MetafuseTech/CHOPPER/README.md

CHOPPER is a 3D-printable pelletizer made to sit on your desk and run on drills or steppers. It can cut filaments and any polymer strand up to 2mm in diameter into ~3mm pellets.

Check the assembly instructions on YouTube : https://www.youtube.com/watch?v=YQxp2BWjgcM

CHOPPER

Metafuse CHOPPER - Open-Source STL Files
Copyright (C) 2025 Metafuse

These STL files are released under the GNU General Public License v3.0 (GPLv3).
You are free to use, share, modify, and remix them, as long as derivative works
are also released under GPLv3.

Trademarks:
The following names and marks are NOT covered by the GPLv3 license and may not
be used for derivative or commercial releases:

- Metafuse
- Subsolid
- Materium
- Metafuse CHOPPER

Derivatives must not imply official affiliation with Metafuse.  
See the LICENSE file for full legal terms.
