MetafuseTech/CHOPPER/3D Print Files/Main Body Front.stl

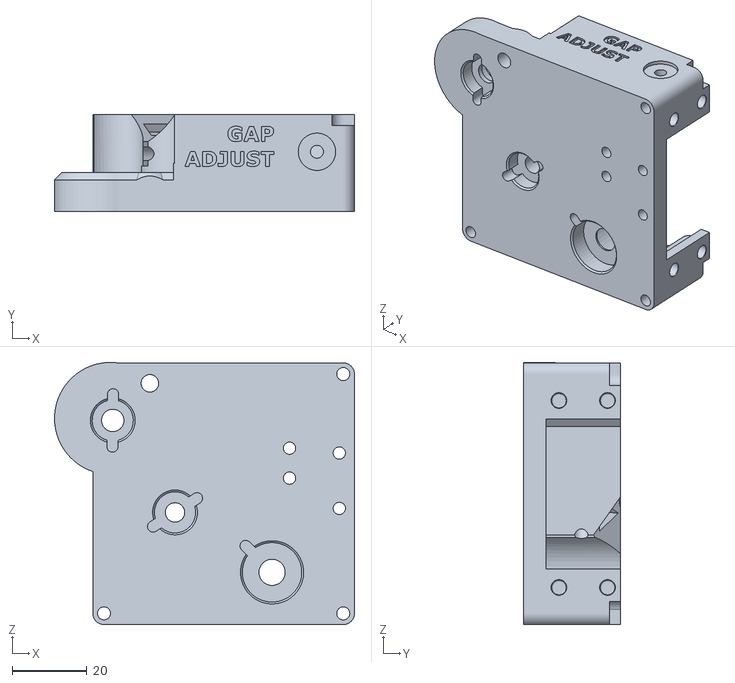
[picture p2: CAD file, 2026-10-27]
3D Print Files/Main Body Front.stl
80.2 x 26.0 x 70.1
