MetafuseTech/CHOPPER/3D Print Files/Main Body Rear.stl

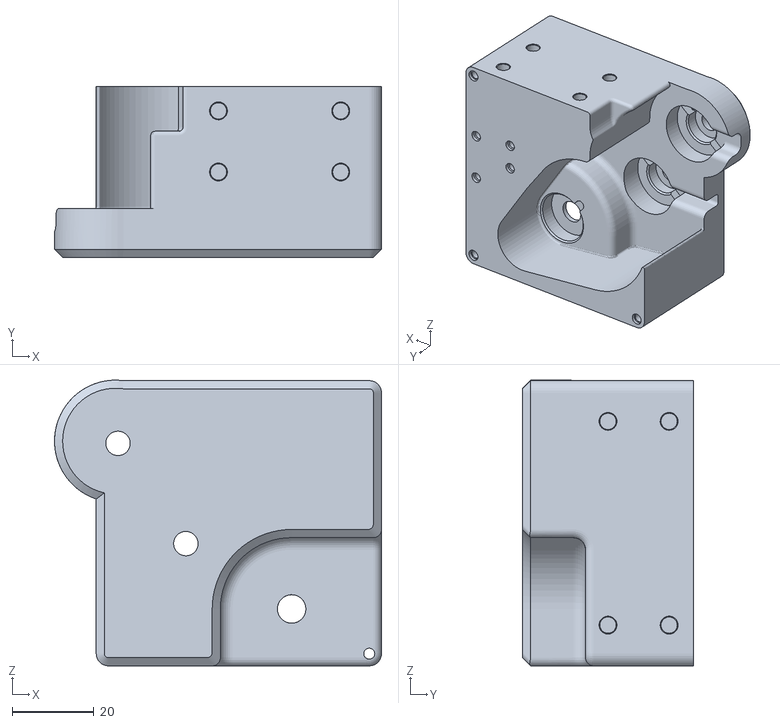
[picture p3: CAD file, 2026-10-27]
3D Print Files/Main Body Rear.stl
80.2 x 42.0 x 70.1
