MetafuseTech/CHOPPER/3D Print Files/Knife Dock.stl

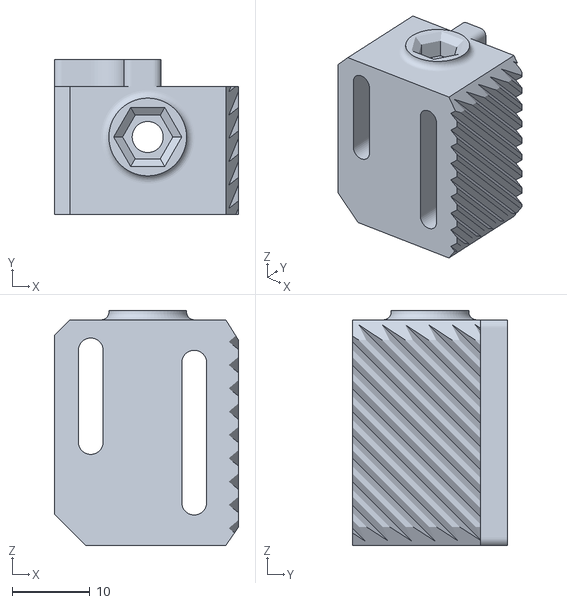
[picture p4: CAD file, 2026-10-27]
3D Print Files/Knife Dock.stl
23.7 x 20.0 x 30.2
