MetafuseTech/CHOPPER/Laser Cut Files/Clear Cover.dxf

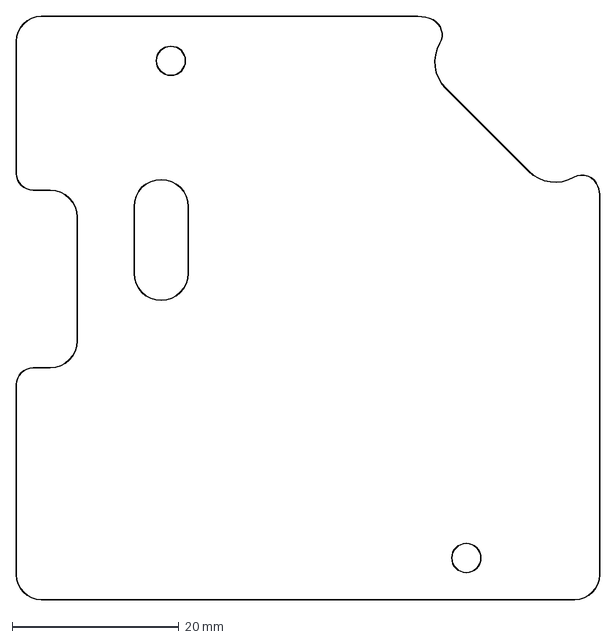
[picture p5: CAD file, 2026-10-27]
Laser Cut Files/Clear Cover.dxf
70.0 x 70.0 mm
