MetafuseTech/CHOPPER/3D Print Files/Stand_A.stl

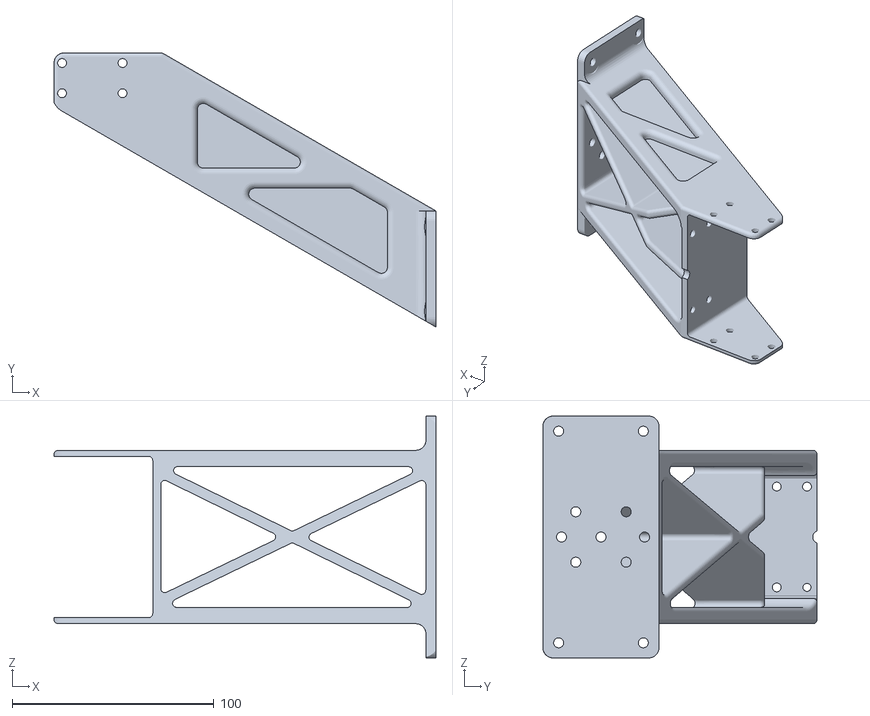
[picture p6: CAD file, 2026-10-27]
3D Print Files/Stand_A.stl
189.5 x 136.0 x 120.0
