MetafuseTech/CHOPPER/3D Print Files/Clear Cover.stl

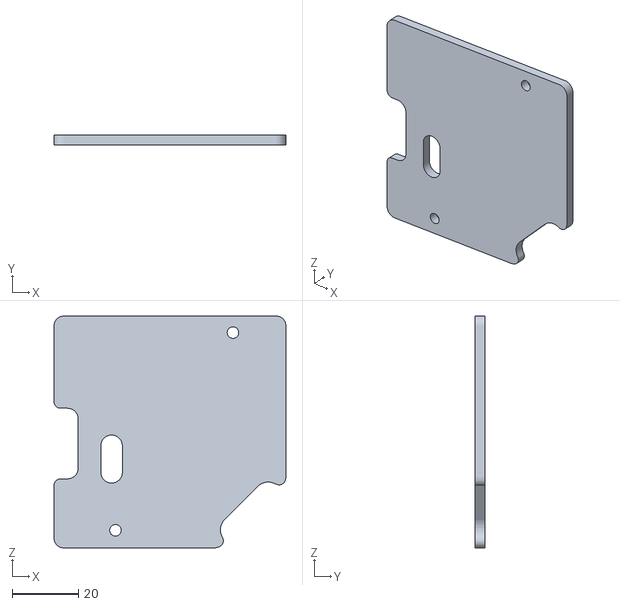
[picture p7: CAD file, 2026-10-27]
3D Print Files/Clear Cover.stl
70.0 x 3.00 x 70.0
