MetafuseTech/CHOPPER/3D Print Files/2020 Mount.stl

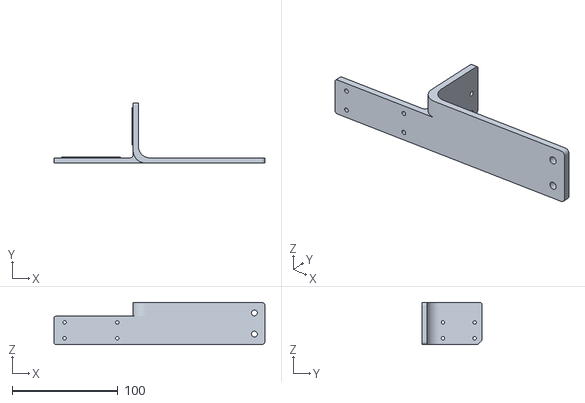
[picture p8: CAD file, 2026-10-27]
3D Print Files/2020 Mount.stl
200.0 x 57.1 x 40.0
