MetafuseTech/CHOPPER/3D Print Files/Spacer.stl

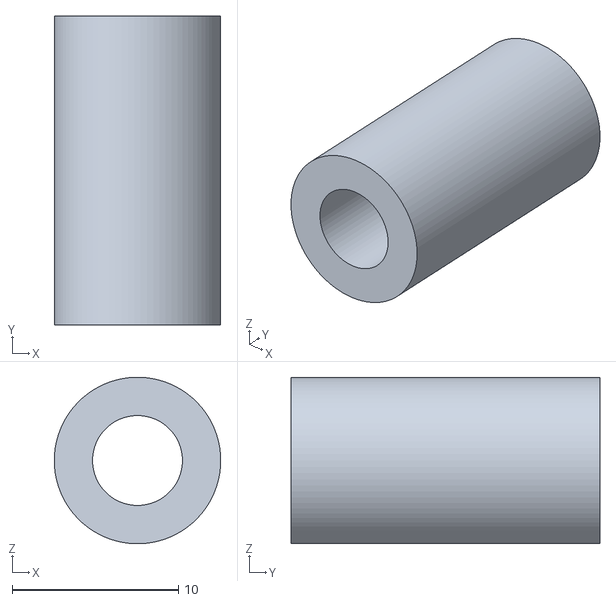
[picture p9: CAD file, 2026-10-27]
3D Print Files/Spacer.stl
10.0 x 18.6 x 9.99
