MetafuseTech/CHOPPER/3D Print Files/NEMA17 PG10 Adapter.stl

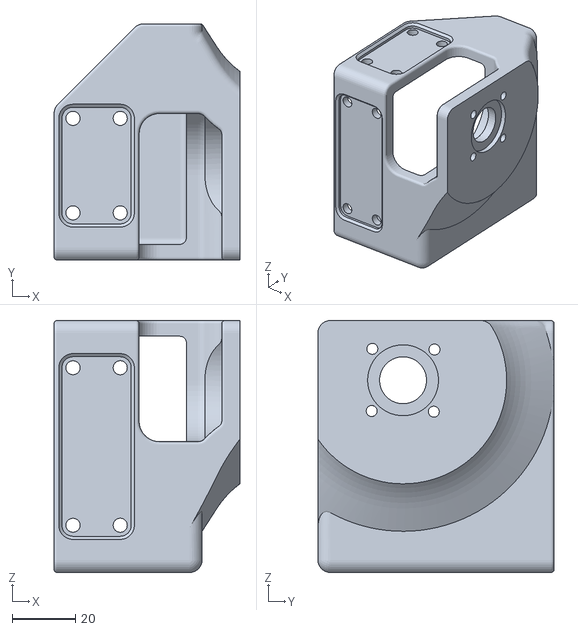
[picture p10: CAD file, 2026-10-27]
3D Print Files/NEMA17 PG10 Adapter.stl
59.0 x 75.0 x 80.0
