MetafuseTech/CHOPPER/3D Print Files/Thumb Adjust.stl

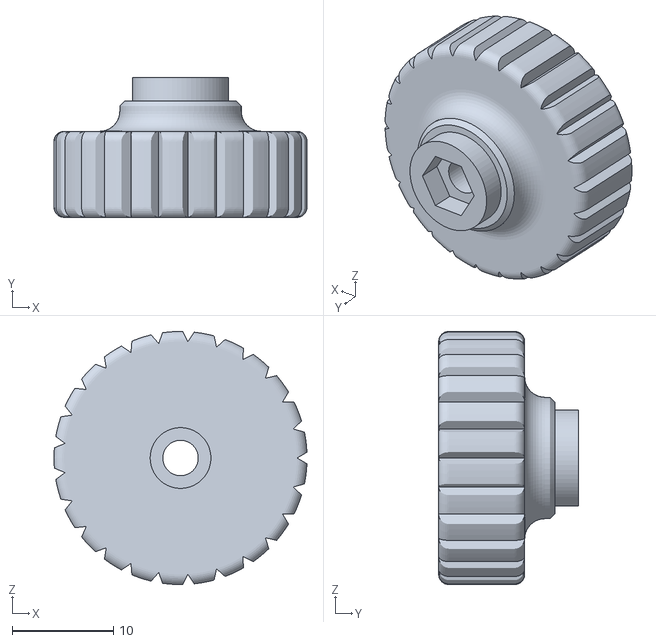
[picture p11: CAD file, 2026-10-27]
3D Print Files/Thumb Adjust.stl
25.0 x 13.8 x 25.0
