MetafuseTech/CHOPPER/3D Print Files/Funnel_Bottle.stl

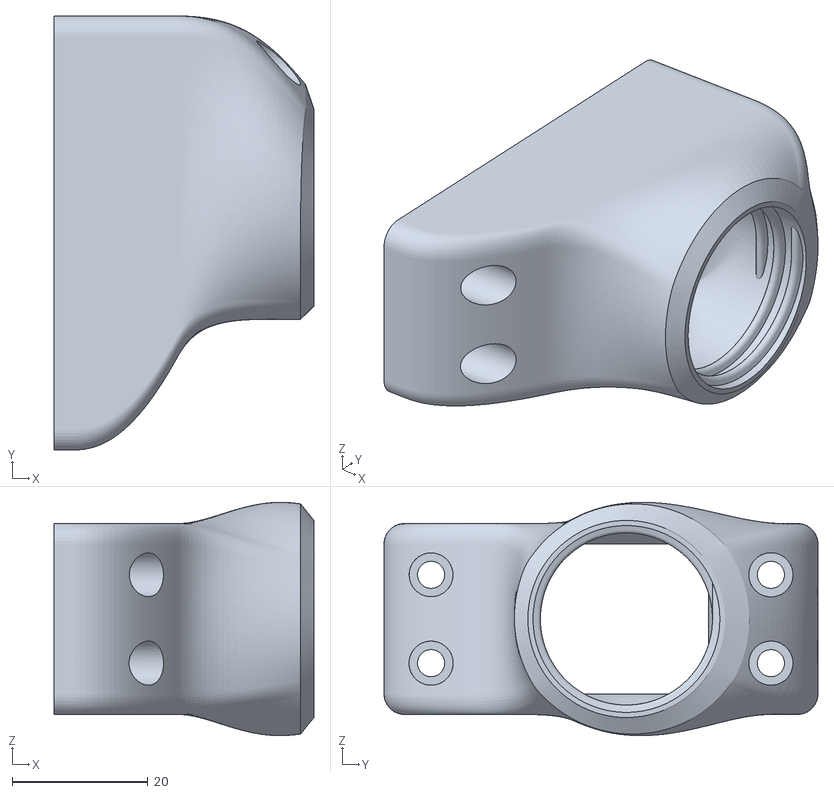
[picture p12: CAD file, 2026-10-27]
3D Print Files/Funnel_Bottle.stl
38.2 x 63.9 x 34.3
