MetafuseTech/CHOPPER/3D Print Files/Roller Brace.stl

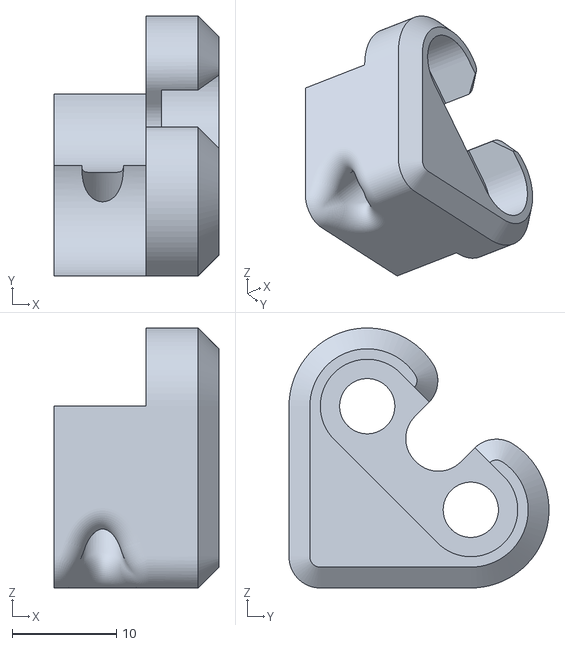
[picture p13: CAD file, 2026-10-27]
3D Print Files/Roller Brace.stl
15.8 x 24.9 x 24.9
