MetafuseTech/CHOPPER/(list of files, cad)

Other CAD files:
Laser Cut Files/Clear Cover.dwg
