MetafuseTech/CHOPPER/3D Print Files/Orientation.png

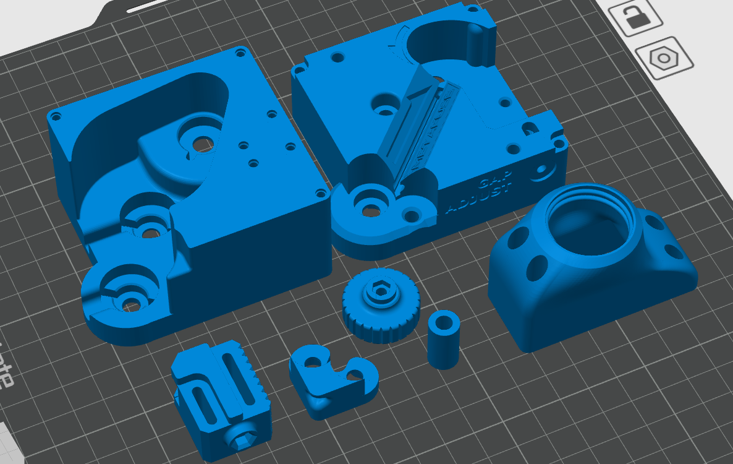
3D Print Files/Orientation.png
