MetafuseTech/CHOPPER/Stepper Tester Box.txt

Stepper Driving Box is a 3D-printable enclosure that houses :
- 1x DM542 Stepper Driver
- 1x LRS150-24 Meanwell PSU
- MKS Stepper Pulse Generator

Instructions available at:

https://makerworld.com/en/models/1991614-stepper-tester-box

and

https://www.printables.com/model/1476074-stepper-tester-box
