MetafuseTech/CHOPPER/(commit log)

2026-10-27 Add files via upload
    Check the assembly instructions on YouTube https://www.youtube.com/watch?v=YQxp2BWjgcM
    [2020 Mount.stl, Clear Cover.dwg, Clear Cover.dxf, Clear Cover.stl, Funnel_Bottle.stl, Knife Dock.stl, Main Body Front.stl, Main Body Rear.stl]
2026-10-27 Update README with CHOPPER description and YouTube link
    Added a brief description of the CHOPPER functionality and assembly instructions.
